mtihlenfield/keyboard_controller/README.md

# CV/Gate Keyboard

An attempt at implementing a CV/Gate keyboard using a raspberry pi pico and an old keybed from a Yamaha PSS-560
