mtihlenfield/keyboard_controller/hardware/keyboard-controller/keyboard-controller.kicad_pcb

## KiCad design hardware/keyboard-controller/keyboard-controller.kicad_pcb (2022-07-23)

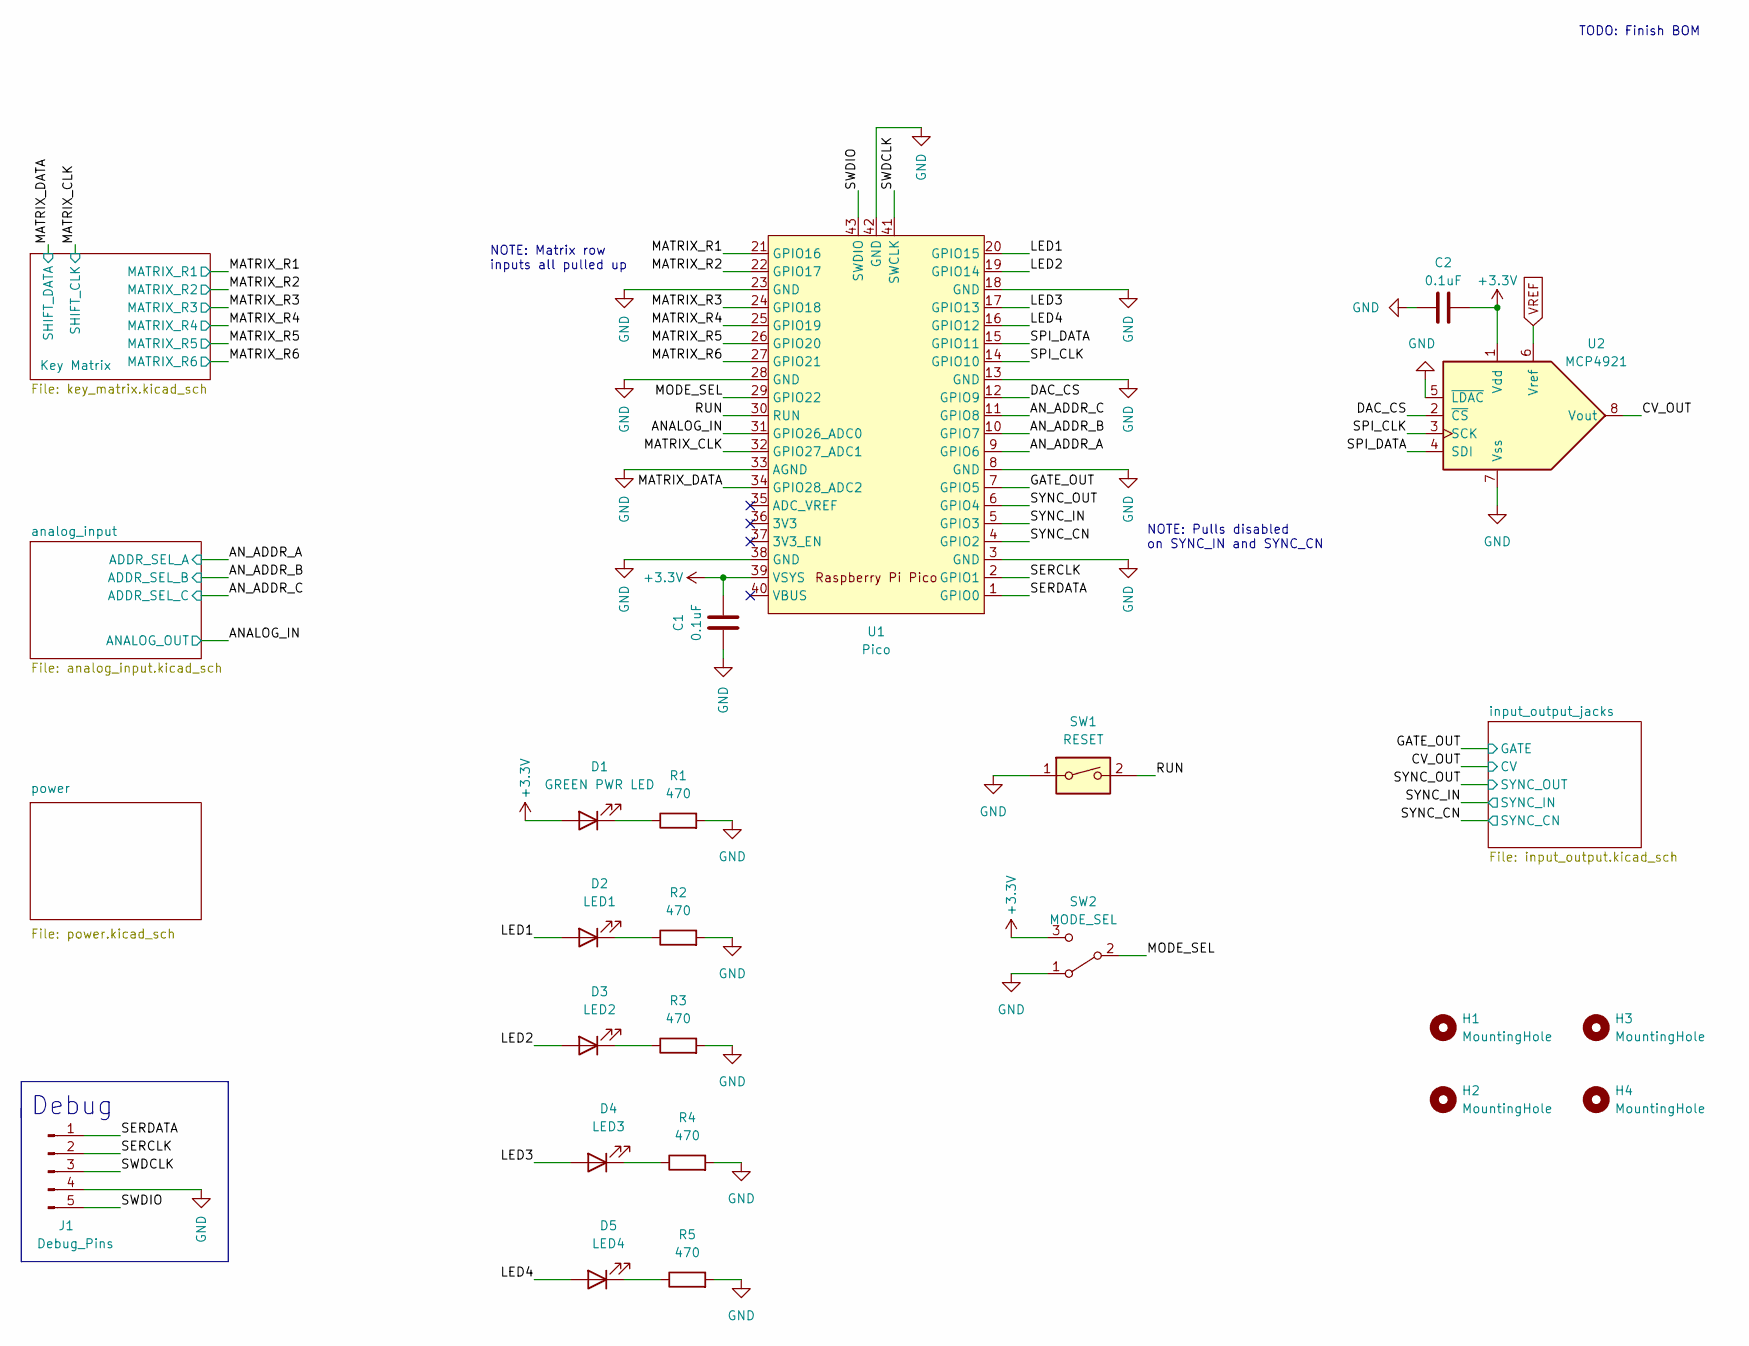
[picture p1: schematic keyboard-controller.kicad_sch, Keyboard Controller]

Parts:
C1, C2: 0.1uF; C_Disc_D5.0mm_W2.5mm_P3.0mm; Manufacturer Part No. 0.1uF 50V Ceramic Disc Capacitor
D1: GREEN PWR LED; LED_D5.0mm; Manufacturer Part No. LED 5mm Green
D2: LED1; LED_D5.0mm; Manufacturer Part No. C503B-RAN-CZ0C0AA1
D3: LED2; LED_D5.0mm; Manufacturer Part No. C503B-RAN-CZ0C0AA1
D4: LED3; LED_D5.0mm; Manufacturer Part No. C503B-RAN-CZ0C0AA1
D5: LED4; LED_D5.0mm; Manufacturer Part No. C503B-RAN-CZ0C0AA1
H1, H2, H3, H4: MountingHole; MountingHole_3.2mm_M3; Manufacturer Part No. N/A
J1: Debug_Pins; PinHeader_1x05_P2.54mm_Vertical; Manufacturer Part No. PHSS05G10
R1, R2, R3, R4, R5: 470; R_Axial_DIN0207_L6.8mm_D2.5mm_P10.16mm_Horizontal
SW1: RESET; SW_PUSH_6mm; Manufacturer Part No. Tact Switch 6x6mm 5mm
SW2: MODE_SEL; Slide_Switch_SPDT_SS12F44G5; Manufacturer Part No. SS12F44G5
U1: Pico; RPi_Pico_SMD_TH
U2: MCP4921; DIP-8_W7.62mm_Socket

Connections:
+3.3V: C1.2, C2.2, D1.2 (A), SW2.3 (C), U1.39 (VSYS), U2.1 (Vdd); also elsewhere on the board
/ANALOG_IN: U1.31 (GPIO26_ADC0); also elsewhere on the board
/AN_ADDR_A: U1.9 (GPIO6); also elsewhere on the board
/AN_ADDR_B: U1.10 (GPIO7); also elsewhere on the board
/AN_ADDR_C: U1.11 (GPIO8); also elsewhere on the board
/CV_OUT: U2.8 (Vout); also elsewhere on the board
/DAC_CS: U1.12 (GPIO9), U2.2 (~CS)
/GATE_OUT: U1.7 (GPIO5); also elsewhere on the board
/LED1: D2.2 (A), U1.20 (GPIO15)
/LED2: D3.2 (A), U1.19 (GPIO14)
/LED3: D4.2 (A), U1.17 (GPIO13)
/LED4: D5.2 (A), U1.16 (GPIO12)
/MATRIX_CLK: U1.32 (GPIO27_ADC1); also elsewhere on the board
/MATRIX_DATA: U1.34 (GPIO28_ADC2); also elsewhere on the board
/MATRIX_R1: U1.21 (GPIO16); also elsewhere on the board
/MATRIX_R2: U1.22 (GPIO17); also elsewhere on the board
/MATRIX_R3: U1.24 (GPIO18); also elsewhere on the board
/MATRIX_R4: U1.25 (GPIO19); also elsewhere on the board
/MATRIX_R5: U1.26 (GPIO20); also elsewhere on the board
/MATRIX_R6: U1.27 (GPIO21); also elsewhere on the board
/MODE_SEL: SW2.2 (B), U1.29 (GPIO22)
/RUN: SW1.2, U1.30 (RUN)
/SERCLK: J1.2, U1.2 (GPIO1)
/SERDATA: J1.1, U1.1 (GPIO0)
/SPI_CLK: U1.14 (GPIO10), U2.3 (SCK)
/SPI_DATA: U1.15 (GPIO11), U2.4 (SDI)
/SWDCLK: J1.3, U1.41 (SWCLK)
/SWDIO: J1.5, U1.43 (SWDIO)
/SYNC_CN: U1.4 (GPIO2); also elsewhere on the board
/SYNC_IN: U1.5 (GPIO3); also elsewhere on the board
/SYNC_OUT: U1.6 (GPIO4); also elsewhere on the board
GND: C1.1, C2.1, J1.4, R1.2, R2.2, R3.2, R4.2, R5.2, SW1.1, SW2.1 (A), U1.3 (GND), U1.8 (GND), U1.13 (GND), U1.18 (GND), U1.23 (GND), U1.28 (GND), U1.33 (AGND), U1.38 (GND), U1.42 (GND), U2.5 (~LDAC), U2.7 (Vss); also elsewhere on the board
unnamed: D1.1 (K), R1.1
unnamed: D2.1 (K), R2.1
unnamed: D3.1 (K), R3.1
unnamed: D4.1 (K), R4.1
unnamed: D5.1 (K), R5.1
VREF: U2.6 (Vref); also elsewhere on the board

Notes on the sheet:
NOTE: Matrix row inputs all pulled up
TODO: Finish BOM
NOTE: Pulls disabled on SYNC_IN and SYNC_CN
Debug

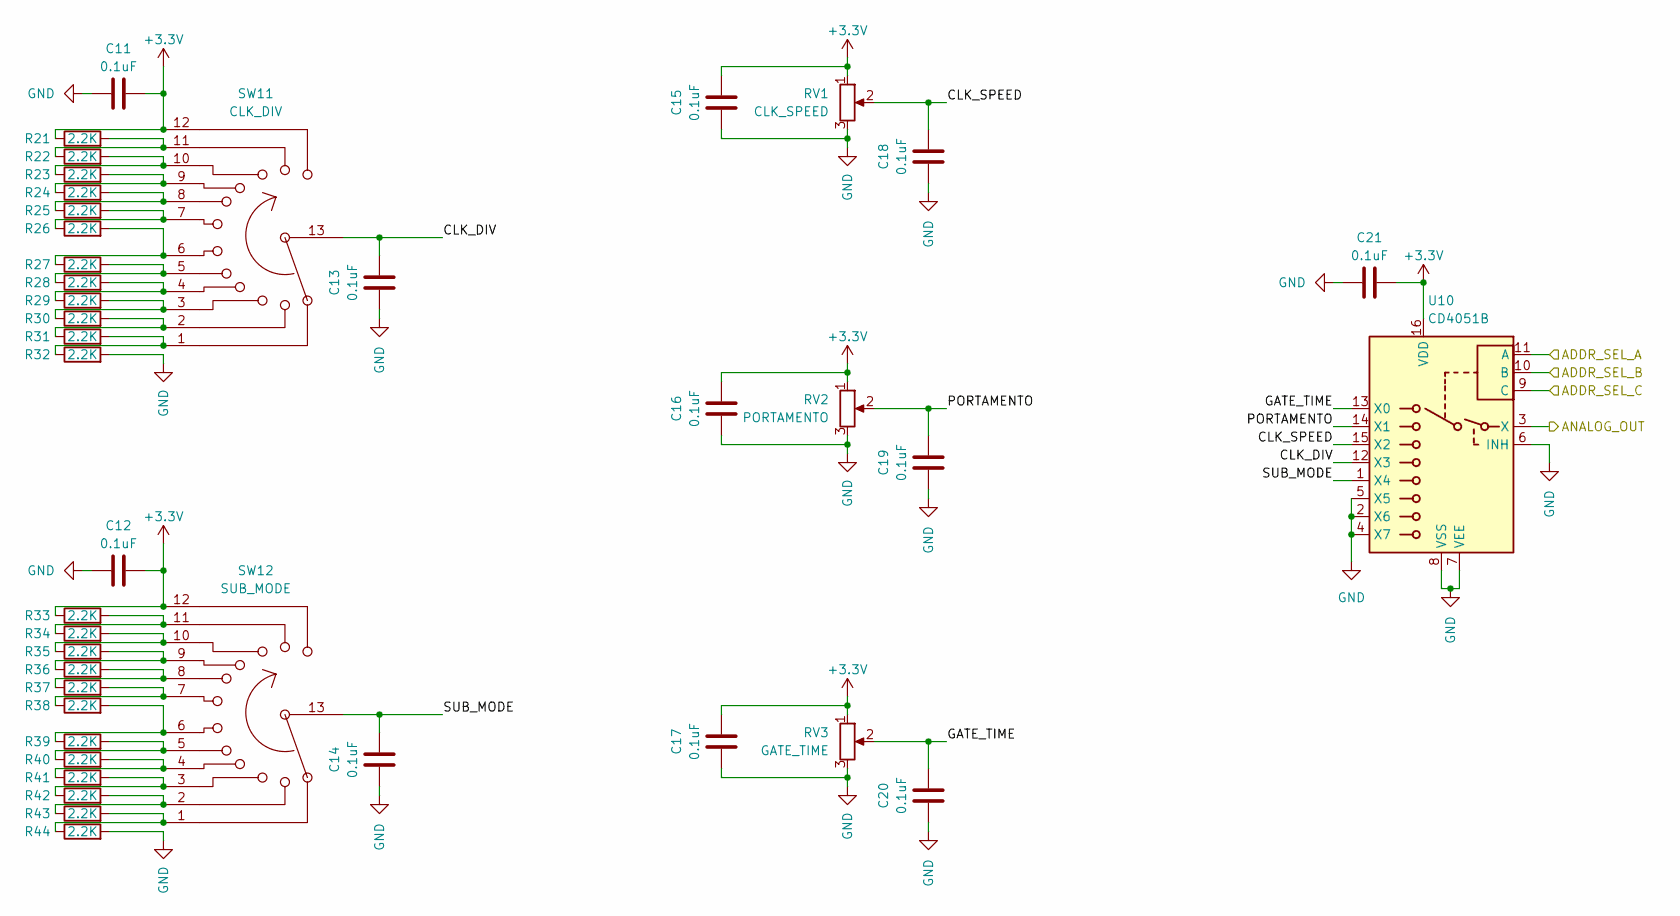
[picture p2: schematic analog_input.kicad_sch, Analog Input]

Parts:
C11, C12, C13, C14, C15, C16, C17, C18, C19, C20, C21: 0.1uF; C_Disc_D5.0mm_W2.5mm_P3.0mm; Manufacturer Part No. 0.1uF 50V Ceramic Disc Capacitor
R21, R22, R23, R24, R25, R26, R27, R28, R29, R30, R31, R32, R33, R34, R35, R36, R37, R38, R39, R40, R41, R42, R43, R44: 2.2K; R_Axial_DIN0207_L6.8mm_D2.5mm_P10.16mm_Horizontal
RV1: CLK_SPEED; Potentiometer_Alpha_RV09AF-40-20K-B1K_Single_Vertical
RV2: PORTAMENTO; Potentiometer_Alpha_RV09AF-40-20K-B1K_Single_Vertical
RV3: GATE_TIME; Potentiometer_Alpha_RV09AF-40-20K-B1K_Single_Vertical
SW11: CLK_DIV; Clock_Div_Switch
SW12: SUB_MODE; Sub_Mode_Switch
U10: CD4051B; DIP-16_W7.62mm_Socket

Connections:
+3.3V: C11.2, C12.2, C15.2, C16.2, C17.2, C21.2, R21.1, R33.1, RV1.1, RV2.1, RV3.1, SW11.12, SW12.12, U10.16 (VDD); also elsewhere on the board
/ANALOG_IN: U10.3 (X); also elsewhere on the board
/AN_ADDR_A: U10.11 (A); also elsewhere on the board
/AN_ADDR_B: U10.10 (B); also elsewhere on the board
/AN_ADDR_C: U10.9 (C); also elsewhere on the board
/analog_input/CLK_DIV: C13.2, SW11.13, U10.12 (X3)
/analog_input/CLK_SPEED: C18.2, RV1.2, U10.15 (X2)
/analog_input/GATE_TIME: C20.2, RV3.2, U10.13 (X0)
/analog_input/PORTAMENTO: C19.2, RV2.2, U10.14 (X1)
/analog_input/SUB_MODE: C14.2, SW12.13, U10.1 (X4)
GND: C11.1, C12.1, C13.1, C14.1, C15.1, C16.1, C17.1, C18.1, C19.1, C20.1, C21.1, R32.2, R44.2, RV1.3, RV2.3, RV3.3, U10.2 (X6), U10.4 (X7), U10.5 (X5), U10.6 (INH), U10.7 (VEE), U10.8 (VSS); also elsewhere on the board
unnamed: R21.2, R22.1, SW11.11
unnamed: R22.2, R23.1, SW11.10
unnamed: R23.2, R24.1, SW11.9
unnamed: R24.2, R25.1, SW11.8
unnamed: R25.2, R26.1, SW11.7
unnamed: R26.2, R27.1, SW11.6
unnamed: R27.2, R28.1, SW11.5
unnamed: R28.2, R29.1, SW11.4
unnamed: R29.2, R30.1, SW11.3
unnamed: R30.2, R31.1, SW11.2
unnamed: R31.2, R32.1, SW11.1
unnamed: R33.2, R34.1, SW12.11
unnamed: R34.2, R35.1, SW12.10
unnamed: R35.2, R36.1, SW12.9
unnamed: R36.2, R37.1, SW12.8
unnamed: R37.2, R38.1, SW12.7
unnamed: R38.2, R39.1, SW12.6
unnamed: R39.2, R40.1, SW12.5
unnamed: R40.2, R41.1, SW12.4
unnamed: R41.2, R42.1, SW12.3
unnamed: R42.2, R43.1, SW12.2
unnamed: R43.2, R44.1, SW12.1

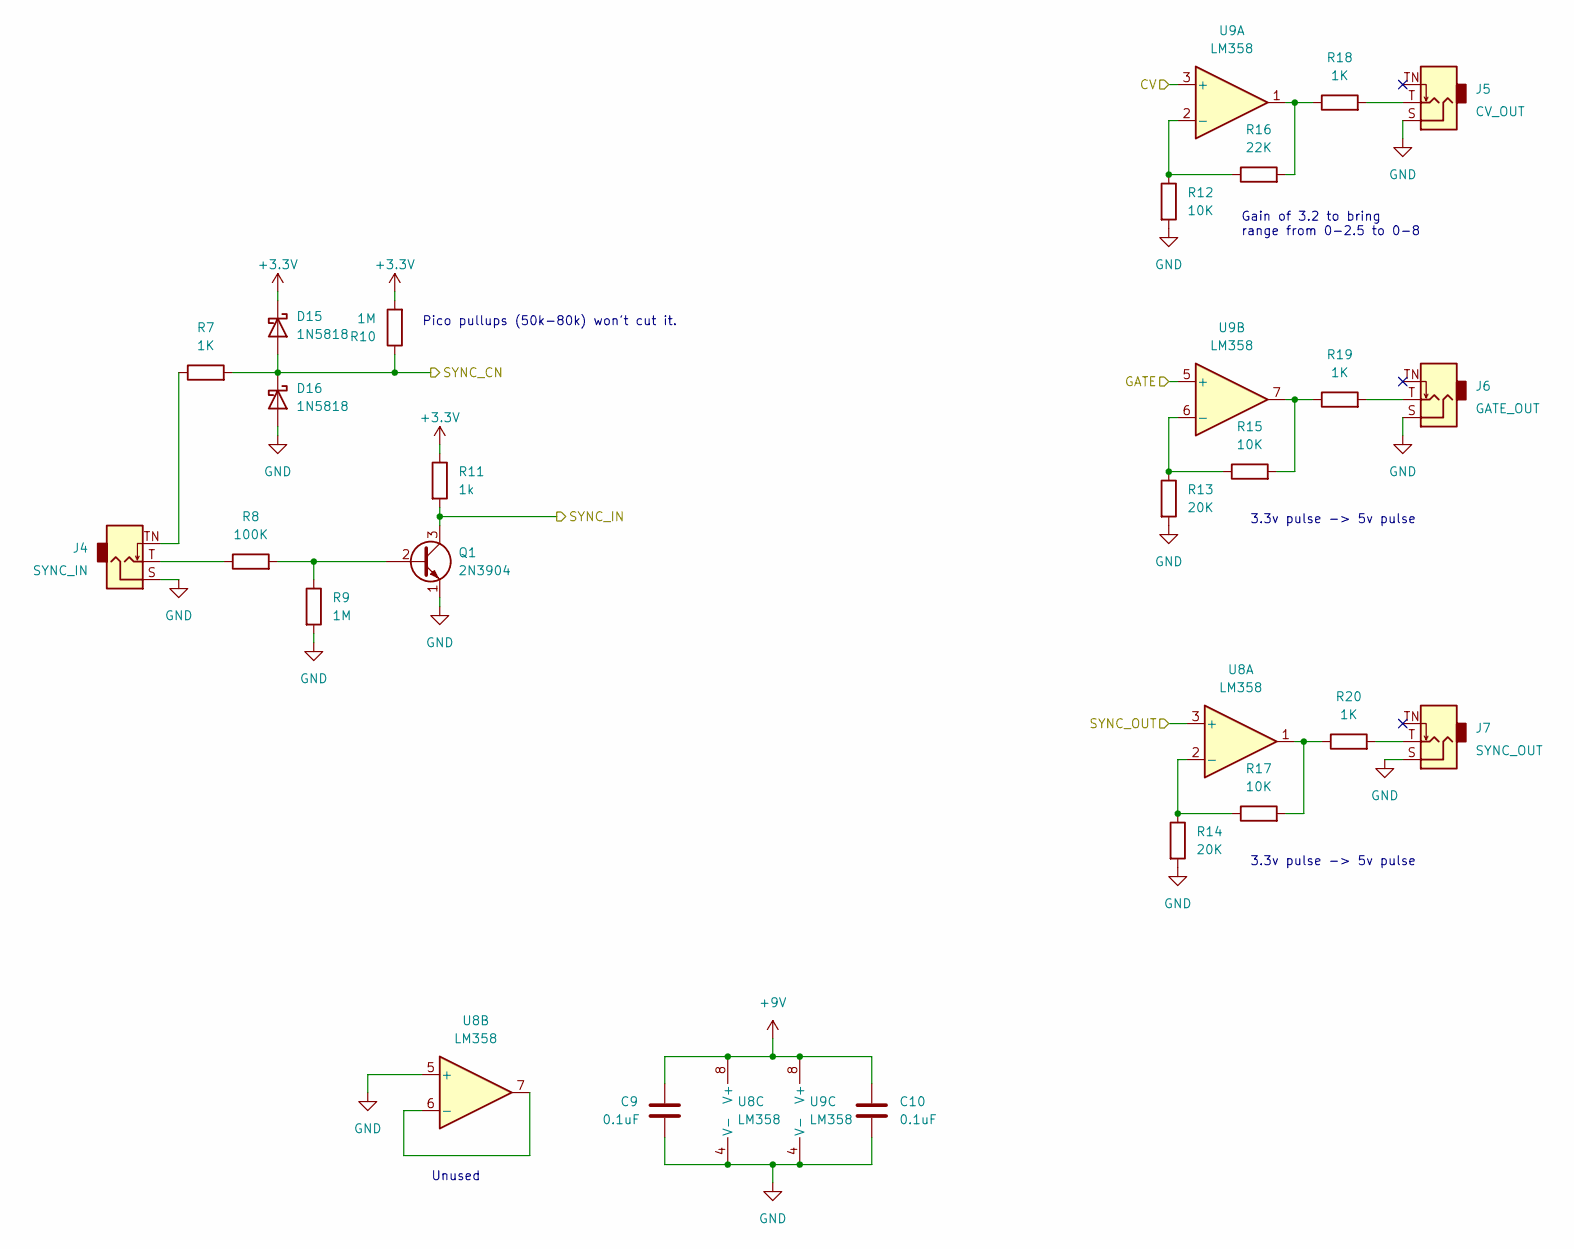
[picture p3: schematic input_output.kicad_sch, Input/Output Jacks]

Parts:
C9, C10: 0.1uF; C_Disc_D5.0mm_W2.5mm_P3.0mm; Manufacturer Part No. 0.1uF 50V Ceramic Disc Capacitor
D15, D16: 1N5818; D_DO-41_SOD81_P10.16mm_Horizontal; Manufacturer Part No. 1N5818
J4: SYNC_IN; Jack_3.5mm_QingPu_WQP-PJ398SM_Vertical; Manufacturer Part No. PJ-629HAN-05
J5: CV_OUT; Jack_3.5mm_QingPu_WQP-PJ398SM_Vertical; Manufacturer Part No. PJ-629HAN-05
J6: GATE_OUT; Jack_3.5mm_QingPu_WQP-PJ398SM_Vertical; Manufacturer Part No. PJ-629HAN-05
J7: SYNC_OUT; Jack_3.5mm_QingPu_WQP-PJ398SM_Vertical; Manufacturer Part No. PJ-629HAN-05
Q1: 2N3904; TO-92_Inline; Manufacturer Part No. 2N3904
R7, R18, R19, R20: 1K; R_Axial_DIN0207_L6.8mm_D2.5mm_P10.16mm_Horizontal
R8: 100K; R_Axial_DIN0207_L6.8mm_D2.5mm_P10.16mm_Horizontal
R9, R10: 1M; R_Axial_DIN0207_L6.8mm_D2.5mm_P10.16mm_Horizontal
R11: 1k; R_Axial_DIN0207_L6.8mm_D2.5mm_P10.16mm_Horizontal
R12, R15, R17: 10K; R_Axial_DIN0207_L6.8mm_D2.5mm_P10.16mm_Horizontal
R13, R14: 20K; R_Axial_DIN0207_L6.8mm_D2.5mm_P10.16mm_Horizontal
R16: 22K; R_Axial_DIN0207_L6.8mm_D2.5mm_P10.16mm_Horizontal
U8, U9: LM358; DIP-8_W7.62mm_Socket

Connections:
+3.3V: D15.1 (K), R10.2, R11.1; also elsewhere on the board
+9V: C9.1, C10.1, U8.8 (V+), U9.8 (V+); also elsewhere on the board
/CV_OUT: U9.3 (+); also elsewhere on the board
/GATE_OUT: U9.5 (+); also elsewhere on the board
/SYNC_CN: D15.2 (A), D16.1 (K), R7.2, R10.1; also elsewhere on the board
/SYNC_IN: Q1.3 (C), R11.2; also elsewhere on the board
/SYNC_OUT: U8.3 (+); also elsewhere on the board
GND: C9.2, C10.2, D16.2 (A), J4.S, J5.S, J6.S, J7.S, Q1.1 (E), R9.2, R12.2, R13.2, R14.2, U8.4 (V-), U8.5 (+), U9.4 (V-); also elsewhere on the board
unnamed: J4.T, R8.1
unnamed: J4.TN, R7.1
unnamed: J5.T, R18.2
unnamed: J6.T, R19.2
unnamed: J7.T, R20.2
unnamed: Q1.2 (B), R8.2, R9.1
unnamed: R12.1, R16.1, U9.2 (-)
unnamed: R13.1, R15.1, U9.6 (-)
unnamed: R14.1, R17.1, U8.2 (-)
unnamed: R15.2, R19.1, U9.7
unnamed: R16.2, R18.1, U9.1
unnamed: R17.2, R20.1, U8.1
unnamed: U8.6 (-), U8.7

Notes on the sheet:
Pico pullups (50k-80k) won't cut it.
3.3v pulse -> 5v pulse
Unused
Gain of 3.2 to bring range from 0-2.5 to 0-8

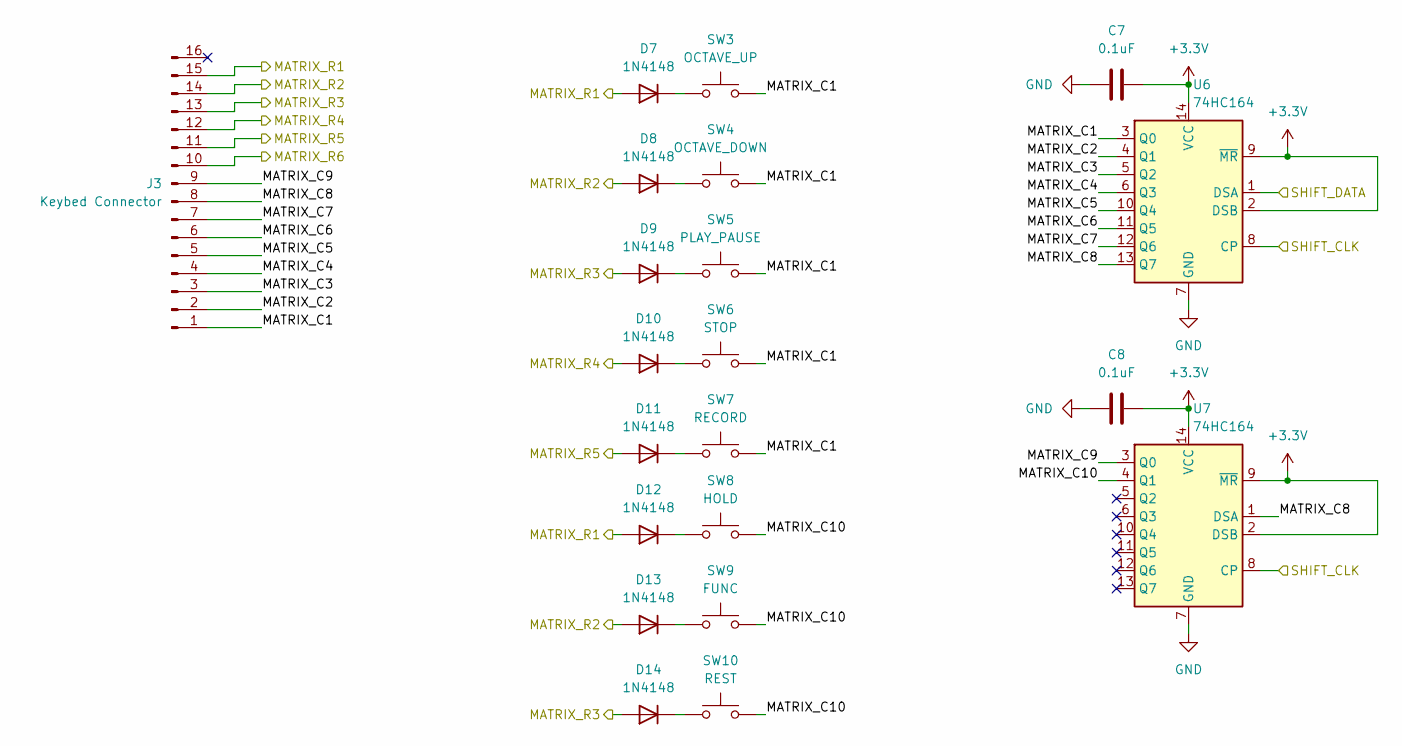
[picture p4: schematic key_matrix.kicad_sch, Key Matrix]

Parts:
C7, C8: 0.1uF; C_Disc_D5.0mm_W2.5mm_P3.0mm; Manufacturer Part No. 0.1uF 50V Ceramic Disc Capacitor
D7, D8, D9, D10, D11, D12, D13, D14: 1N4148; D_DO-35_SOD27_P7.62mm_Horizontal; Manufacturer Part No. 1N4148
J3: Keybed Connector; IDC-Header_2x08_P2.54mm_Vertical; Manufacturer Part No. BHD16PHZT
SW3: OCTAVE_UP; SW_PUSH_6mm; Manufacturer Part No. Tact Switch 6x6mm 5mm
SW4: OCTAVE_DOWN; SW_PUSH_6mm; Manufacturer Part No. Tact Switch 6x6mm 5mm
SW5: PLAY_PAUSE; SW_PUSH_6mm; Manufacturer Part No. Tact Switch 6x6mm 5mm
SW6: STOP; SW_PUSH_6mm; Manufacturer Part No. Tact Switch 6x6mm 5mm
SW7: RECORD; SW_PUSH_6mm; Manufacturer Part No. Tact Switch 6x6mm 5mm
SW8: HOLD; SW_PUSH_6mm; Manufacturer Part No. Tact Switch 6x6mm 5mm
SW9: FUNC; SW_PUSH_6mm; Manufacturer Part No. Tact Switch 6x6mm 5mm
SW10: REST; SW_PUSH_6mm; Manufacturer Part No. Tact Switch 6x6mm 5mm
U6, U7: 74HC164; DIP-14_W7.62mm_Socket

Connections:
+3.3V: C7.2, C8.2, U6.2 (DSB), U6.9 (~MR), U6.14 (VCC), U7.2 (DSB), U7.9 (~MR), U7.14 (VCC); also elsewhere on the board
/Key Matrix/MATRIX_C1: J3.1, SW3.2, SW4.2, SW5.2, SW6.2, SW7.2, U6.3 (Q0)
/Key Matrix/MATRIX_C2: J3.2, U6.4 (Q1)
/Key Matrix/MATRIX_C3: J3.3, U6.5 (Q2)
/Key Matrix/MATRIX_C4: J3.4, U6.6 (Q3)
/Key Matrix/MATRIX_C5: J3.5, U6.10 (Q4)
/Key Matrix/MATRIX_C6: J3.6, U6.11 (Q5)
/Key Matrix/MATRIX_C7: J3.7, U6.12 (Q6)
/Key Matrix/MATRIX_C8: J3.8, U6.13 (Q7), U7.1 (DSA)
/Key Matrix/MATRIX_C9: J3.9, U7.3 (Q0)
/Key Matrix/MATRIX_C10: SW8.2, SW9.2, SW10.2, U7.4 (Q1)
/MATRIX_CLK: U6.8 (CP), U7.8 (CP); also elsewhere on the board
/MATRIX_DATA: U6.1 (DSA); also elsewhere on the board
/MATRIX_R1: D7.2 (A), D12.2 (A), J3.15; also elsewhere on the board
/MATRIX_R2: D8.2 (A), D13.2 (A), J3.14; also elsewhere on the board
/MATRIX_R3: D9.2 (A), D14.2 (A), J3.13; also elsewhere on the board
/MATRIX_R4: D10.2 (A), J3.12; also elsewhere on the board
/MATRIX_R5: D11.2 (A), J3.11; also elsewhere on the board
/MATRIX_R6: J3.10; also elsewhere on the board
GND: C7.1, C8.1, U6.7 (GND), U7.7 (GND); also elsewhere on the board
unnamed: D7.1 (K), SW3.1
unnamed: D8.1 (K), SW4.1
unnamed: D9.1 (K), SW5.1
unnamed: D10.1 (K), SW6.1
unnamed: D11.1 (K), SW7.1
unnamed: D12.1 (K), SW8.1
unnamed: D13.1 (K), SW9.1
unnamed: D14.1 (K), SW10.1

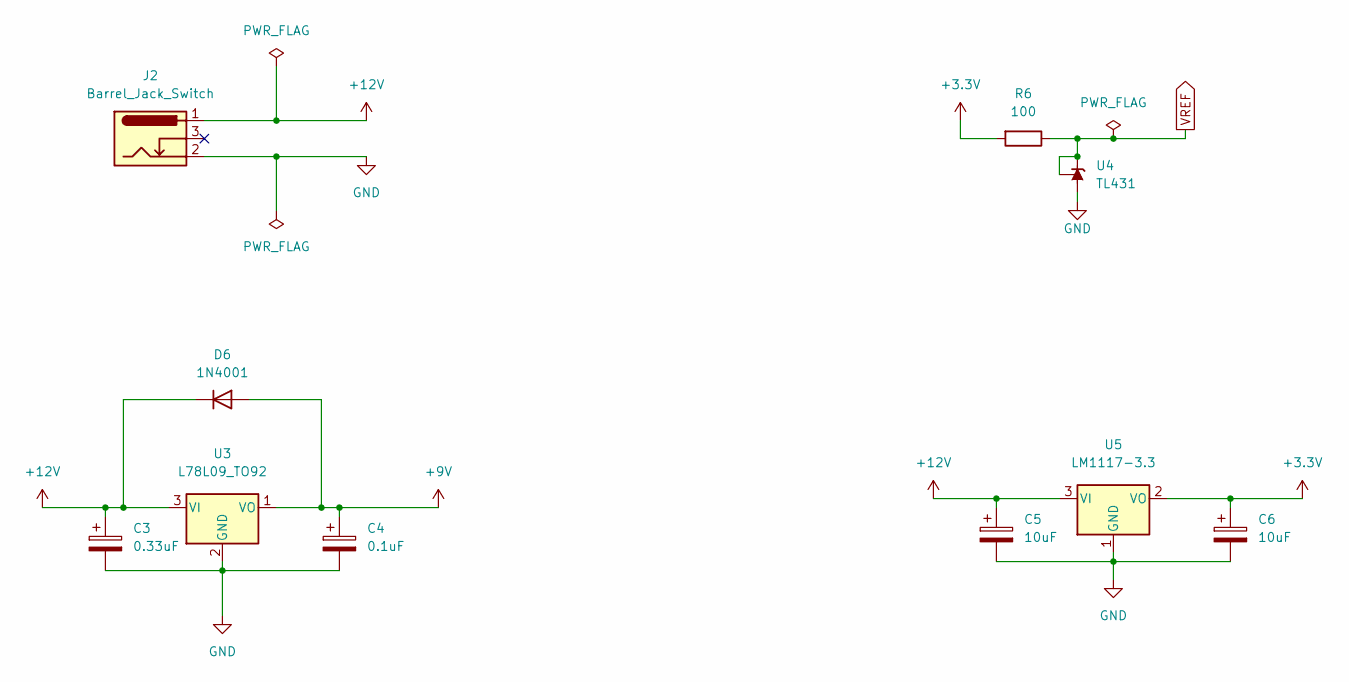
[picture p5: schematic power.kicad_sch]

Parts:
C3: 0.33uF; CP_Radial_Tantal_D4.5mm_P2.50mm; Manufacturer Part No. 0.33uF 35V Radial Capacitor Tantalum
C4: 0.1uF; CP_Radial_Tantal_D4.5mm_P2.50mm; Manufacturer Part No. 0.1uF 35V Radial Capacitor Tantalum
C5, C6: 10uF; CP_Radial_Tantal_D4.5mm_P2.50mm; Manufacturer Part No. 10uF 35V Radial Capacitor Tantalum
D6: 1N4001; D_DO-41_SOD81_P10.16mm_Horizontal; Manufacturer Part No. 1N4001
J2: Barrel_Jack_Switch; BarrelJack_Horizontal_2.1mm_WEALTH_METAL; Manufacturer Part No. DC Power Jack 2.1mm
R6: 100; R_Axial_DIN0207_L6.8mm_D2.5mm_P10.16mm_Horizontal
U3: L78L09_TO92; TO-92_Inline
U4: TL431; TO-92_Inline; Manufacturer Part No. TL431ACL
U5: LM1117-3.3; TO-220-3_Horizontal_TabDown

Connections:
+3.3V: C6.1, R6.2, U5.2 (VO); also elsewhere on the board
+9V: C4.1, D6.2 (A), U3.1 (VO); also elsewhere on the board
+12V: C3.1, C5.1, D6.1 (K), J2.1, U3.3 (VI), U5.3 (VI)
GND: C3.2, C4.2, C5.2, C6.2, J2.2, U3.2 (GND), U4.2 (A), U5.1 (GND); also elsewhere on the board
VREF: R6.1, U4.1 (REF), U4.3 (K); also elsewhere on the board

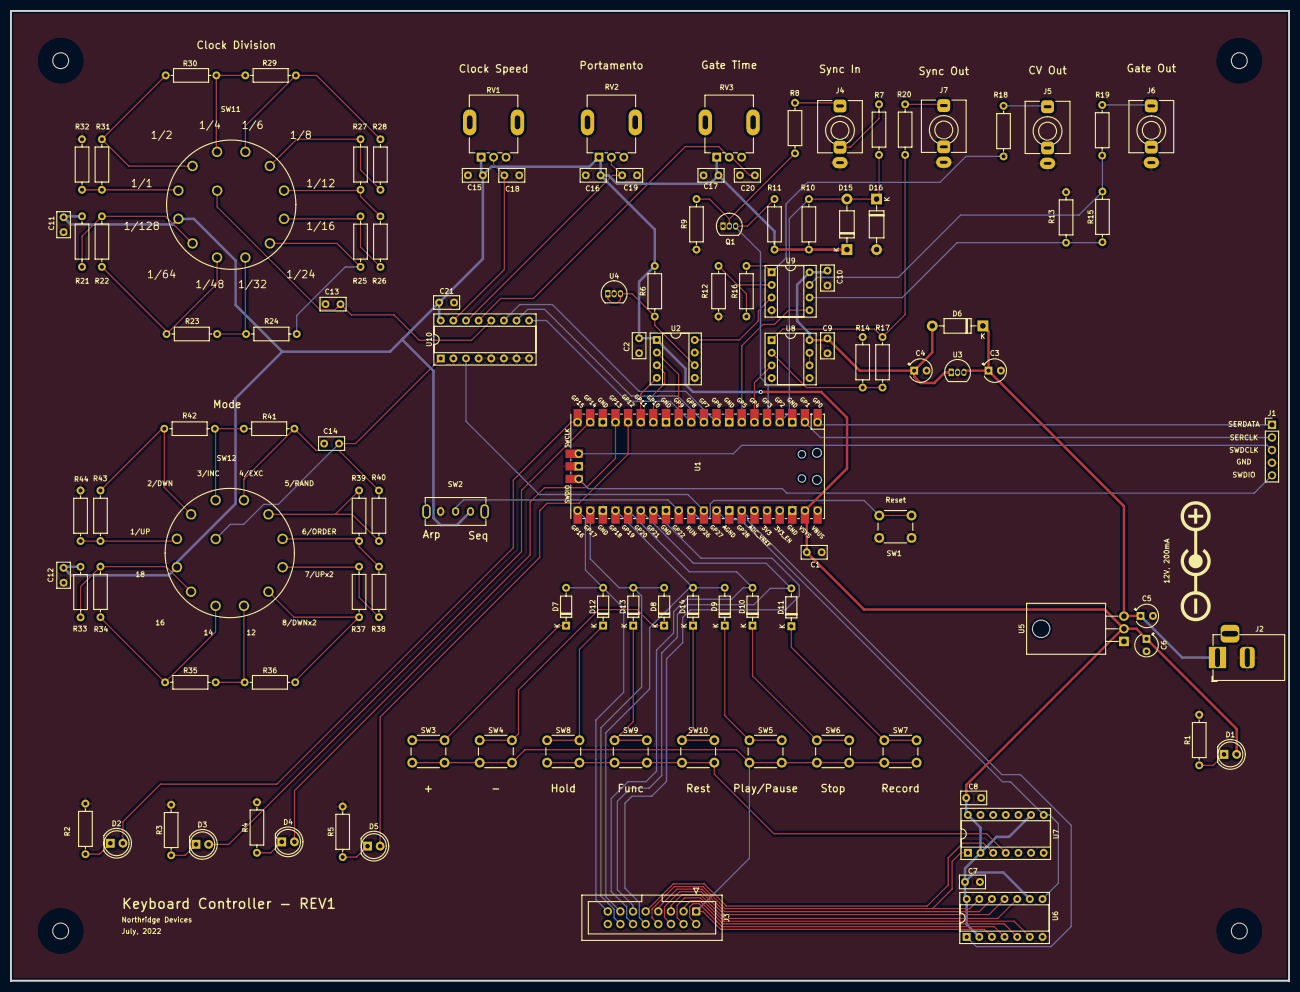
[picture p6: board keyboard-controller.kicad_pcb from above]

Board: 2 copper layers, 257.0 x 195.0 mm, 118 parts (0 on the bottom side), 98 nets.
