mtihlenfield/keyboard_controller/(commit log)

2022-03-31 Added initial key matrix code and cleaned up repo
    [keyboard-controller.kicad_pcb, keyboard-controller.kicad_sch]
2022-03-31 Added voltage regulators and power input to schematic
    [keyboard-controller.kicad_sch]
2022-03-31 Reorganized hardware folder to keep libraries locally. Added footprints to most symbols
    [keyboard-controller.kicad_pcb, keyboard-controller.kicad_sch]
2022-03-31 Removed pico-sdk
2022-03-31 Fixed pico-sdk submodule
2022-04-01 Added cv/gate output jacks
    [keyboard-controller.kicad_sch]
2022-04-04 Schematic updates: Added filter caps on all ICs, resolved some TODOs
    [keyboard-controller.kicad_pcb, keyboard-controller.kicad_sch]
2022-04-06 Fixed shift register <-> pico pins in schematic. Moved shift register clk/data pins
    [keyboard-controller.kicad_sch]
2022-04-10 Implemented main keyboard functionality
    [keyboard-controller.kicad_sch]
2022-04-12 Code cleanup. Switched keyboard connector to 16pin IDC
    [keyboard-controller.kicad_pcb, keyboard-controller.kicad_sch]
2022-04-18 Switched over to using queues/polling rather than fifo/irq
2022-04-19 Reworked matrix scanning to use a timer rather than a scanning loop.
    [key_matrix.c, keyboard.c]
2022-04-19 Added octave shift buttons
    [keyboard-controller.kicad_sch]
2022-04-26 Tidied schematic
    [keyboard-controller.kicad_pcb, keyboard-controller.kicad_sch]
2022-05-27 Added more IO
    [input_output.kicad_sch, key_matrix.kicad_sch, keyboard-controller.kicad_pcb, keyboard-controller.kicad_sch, power.kicad_sch]
2022-05-28 Added hardware_config.h and updated pin configuration
2022-05-28 Added filter caps on pots and rotary switches
    [input_output.kicad_sch, keyboard-controller.kicad_sch]
2022-05-29 Added analog switch for analog input
    [analog_input.kicad_sch, input_output.kicad_sch, key_matrix.kicad_sch, keyboard-controller.kicad_sch]
2022-06-18 Added footprint for rotary switches
    [analog_input.kicad_sch, input_output.kicad_sch, key_matrix.kicad_sch, keyboard-controller.kicad_sch, power.kicad_sch]
2022-06-19 Updated hardware_config and fixed sync_cn
    [analog_input.kicad_sch, input_output.kicad_sch, key_matrix.kicad_sch, keyboard-controller.kicad_pcb, keyboard-controller.kicad_sch, power.kicad_sch]
2022-06-27 Completed schematic rev1. Started placing pcb
    [analog_input.kicad_sch, input_output.kicad_sch, key_matrix.kicad_sch, keyboard-controller.kicad_pcb, keyboard-controller.kicad_sch]
2022-07-17 Completed initial pcb design
    [analog_input.kicad_sch, input_output.kicad_sch, key_matrix.kicad_sch, keyboard-controller.kicad_sch, power.kicad_sch]
2022-07-23 Converted PCB to 2-layer
    [key_matrix.kicad_sch, keyboard-controller.kicad_sch]
2022-07-23 Added more text detail to PCB. Completed more of BOM
    [input_output.kicad_sch, key_matrix.kicad_sch, keyboard-controller.kicad_pcb, keyboard-controller.kicad_sch, power.kicad_sch]
2022-07-23 Cleaned up tracks
    [keyboard-controller.kicad_pcb]
2022-07-23 Completed BOM
    [analog_input.kicad_sch, input_output.kicad_sch, key_matrix.kicad_sch, keyboard-controller.csv, keyboard-controller.kicad_sch, power.kicad_sch]
